pipyns/pipyns.github.io/README.md

# Pipyns -- MTE 481/482 Capstone Endeavor
## Powered by: [TeXt Theme](https://github.com/kitian616/jekyll-TeXt-theme)
