pipyns/pipyns.github.io/_posts/2024-02-18-w17.md

---
title: Capstone Week 17 - Feb 12 to Feb 18 Updates
tags: meeting-notes
show_edit_on_github: false
show_subscribe: false
---

<style>
  img {
  display: block;
  margin-left: auto;
  margin-right: auto;
  }
</style>

## WEEK 17

Week 17 is Week 6 of the W24 term.

### Meeting with Professors
This week the 2nd Meeting with advisors has taken place. The team summarized the progress made over the first half of the term - the meeting was meant as an intermediate check before presenting a working prototype in the final 3rd Meeting.

### Team Progress Update

The weekly meeting was utilized to come up with a roadmap of remaining tasks in all areas.

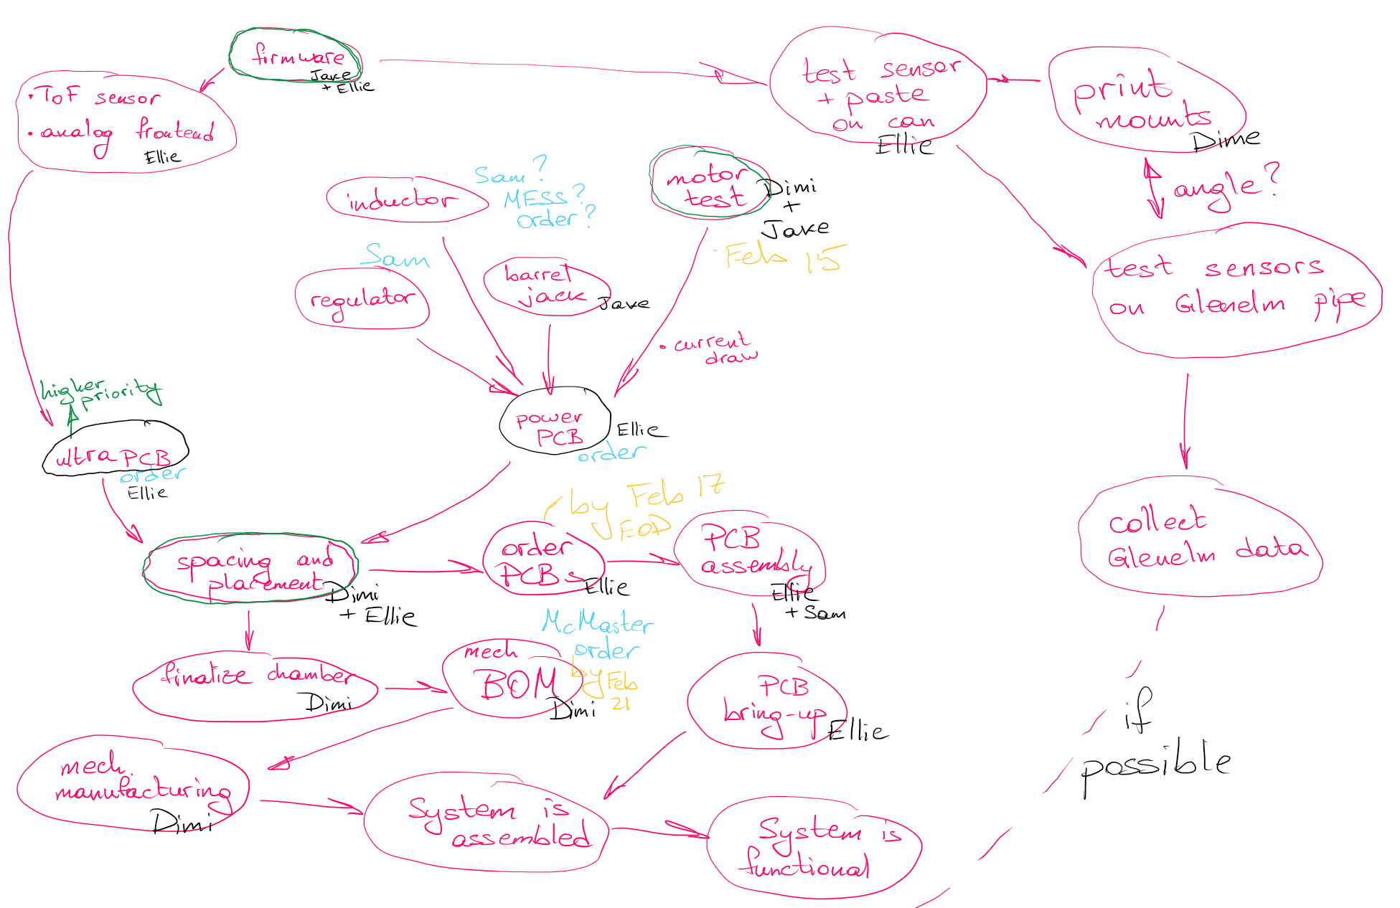
[picture p4: assets/Roadmap1.png]
Image of the first half of the task roadmap


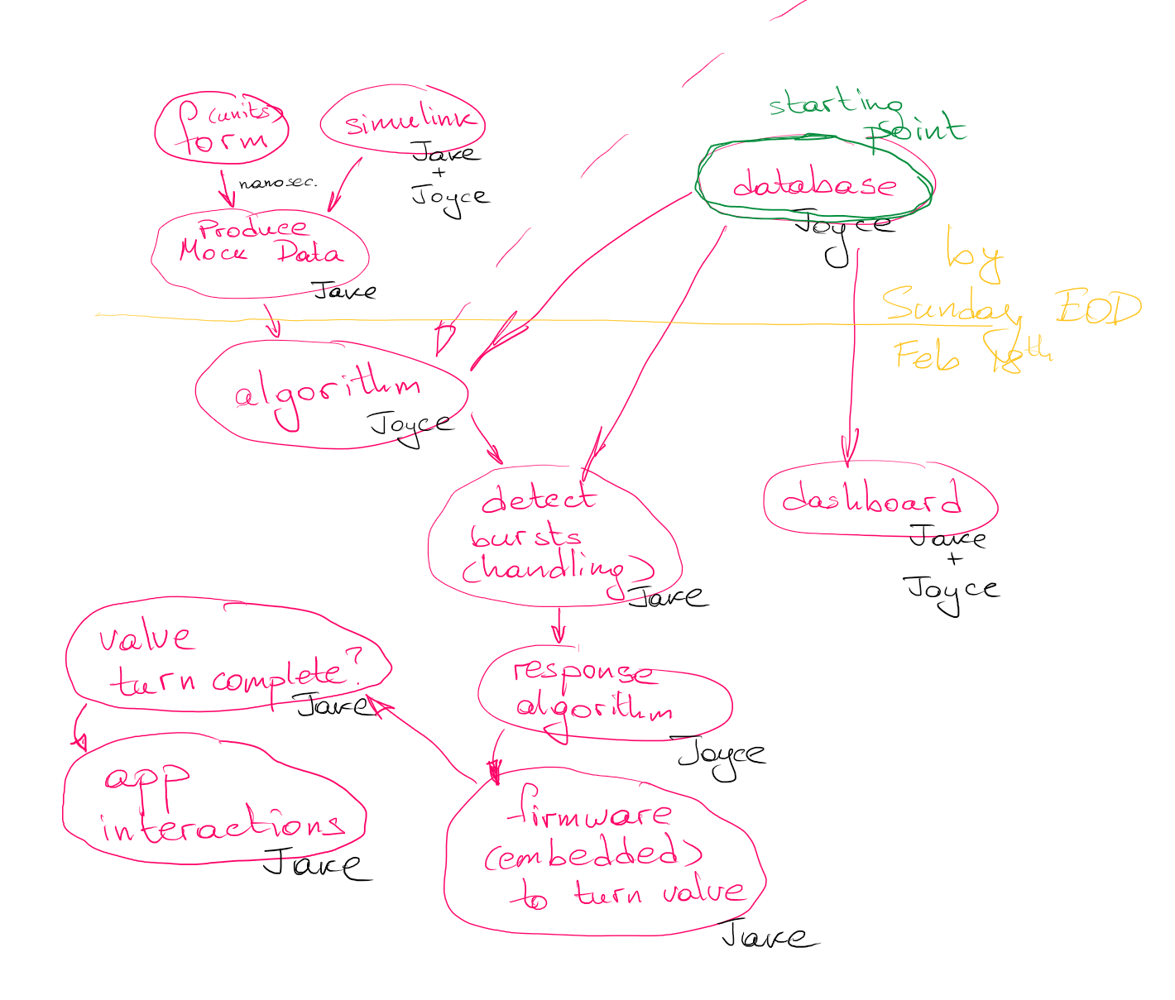
[picture p5: assets/Roadmap2.png]
Image of the second half of the task roadmap


The motor was once again tested to record the current draw, which has shown that the peak does not exceed 2A in typical actuation.

The mechanical design of the waterproof enclosure was reworked into a flatter configuration to redistribute the mass of the system.

The Ultrasonic PCB and the Power PCB were finalized based on the new chamber dimensions and ordered for manufacturing.

### Jake's Weekly Updates
I am literally the messiah

Editor's note: he is
  
<iframe style="border-radius:12px" src="https://open.spotify.com/embed/track/58KPPL1AdLHMvR2O2PZejr?utm_source=generator" width="100%" height="152" frameBorder="0" allowfullscreen="" allow="autoplay; clipboard-write; encrypted-media; fullscreen; picture-in-picture" loading="lazy"></iframe>

<!--more-->
