pipyns/pipyns.github.io/_posts/2024-02-25-w18.md

---
title: Capstone Week 18
tags: meeting-notes
show_edit_on_github: false
show_subscribe: false
---

<style>
  img {
  display: block;
  margin-left: auto;
  margin-right: auto;
  }
</style>

## WEEK 18

Week 18 is Week 7 and the Reading Week of the W24 term.

### Team Progress Update
For this week, the size of the waterproof enclosure for the system was finalized and the parts for it were ordered. On the software side, the simulation for the toilet was successfully completed with the other parts of the washroom still in progress. 
The PCBs on the other awaited their delivery.. 

### Jake's Weekly Updates
"unfortunately the board is not boarding anymore so..."  
<iframe style="border-radius:12px" src="https://open.spotify.com/embed/track/44TuSOP6xIAEeJmZsN3nXO?utm_source=generator" width="100%" height="152" frameBorder="0" allowfullscreen="" allow="autoplay; clipboard-write; encrypted-media; fullscreen; picture-in-picture" loading="lazy"></iframe>

<!--more-->
