pipyns/pipyns.github.io/about.md

---
layout: article
titles:
  # @start locale config
  en      : &EN       About
  en-GB   : *EN
  en-US   : *EN
  en-CA   : *EN
  en-AU   : *EN
  zh-Hans : &ZH_HANS  关于
  zh      : *ZH_HANS
  zh-CN   : *ZH_HANS
  zh-SG   : *ZH_HANS
  zh-Hant : &ZH_HANT  關於
  zh-TW   : *ZH_HANT
  zh-HK   : *ZH_HANT
  ko      : &KO       소개
  ko-KR   : *KO
  fr      : &FR       À propos
  fr-BE   : *FR
  fr-CA   : *FR
  fr-CH   : *FR
  fr-FR   : *FR
  fr-LU   : *FR
  # @end locale config
key: page-about
---

<style>
img {
  display: block;
  margin-left: auto;
  margin-right: auto;
}
</style>

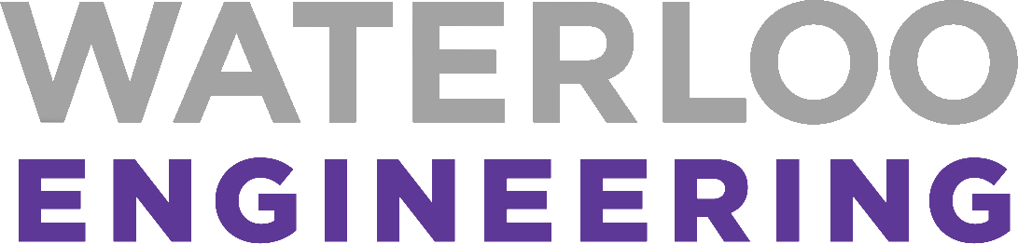
[picture p12: assets/UW_ENG.png]
University of Waterloo


Our team is comprised of Dmitrii Tcyrenov, Ellie Xu, Joyce Ke, and Jakeb Chouinard -- all 4th year Mechatronics Engineering students at the University of Waterloo in Waterloo, Ontario. Thanks to their diverse skillset and previous experiences across different industries, there is no part of this project that seems undoable. Dmitrii is largely mechanically-oriented, having extensive experience in mechanical design and rapid prototyping. Ellie has a variety of experience between electrical and back-end software development, though she will be primarily focused on Electrical system design andily  PCB development. Joyce's experience is largely split between front-end, back-end, and application software development; she will be focusing on the development of the stack necessary to execute this project successfully. Jakeb has experience evenly split between manufacturing and software development. Consequently, his skillset is more varied, and he will be flexibly assisting in each system's development with a focus on software, electronic, and mechanical integration.

If you would like to get in touch with any member of our team, please email pipyns@gmail.com.
