pipyns/pipyns.github.io/ee/old/bandpass filter calculations.docx

Stage 1 calculations

gain= -(R_2)/(R_1), f_(c1) =1/(2πR_1 C_1), f_(c2) =1/(2πR_2 C_2)

Ultrasonic frequency range: 945 KHz – 1005 KHz

Assume input signal is 1 mV, typical of several other ultrasonic flow meters.

total amplification required=5/0.001=5000 max⁡

amplification per stage=√5000=70.7 per stage

Let R1 = 1200 ohms, R2 = 80 000 ohms. Gain = 66.67. Total gain = 4444.67

Let C1 = 150 pF, C2 = 1.8 pF

f_(c1) =1/(2π1200*150*10^(-12))=884 KHz

f_(c2) =1/(2π80000*1.8*10^(-12))=1.105 MHz

Same values for the second stage.

Two stage filter for a roll off gain of -40dB/dec on both corners.
