pipyns/pipyns.github.io/ee/old/BOM.xlsx

Name | Value | Digikey Link | Quantity | Price each | Total
Cap 0805 | 2.7nF | https://www.digikey.ca/en/products/detail/kemet/C0805C272KDRACAUTO/8109833 | 3 | 0.61 | 1.83
Cap 0805 | 10nF | https://www.digikey.ca/en/products/detail/kemet/C0805C103KCRACAUTO/8109825 | 5 | 0.43 | 2.15
Cap 0805 | 22uF | https://www.digikey.ca/en/products/detail/samsung-electro-mechanics/CL21A226KQCLRNC/5961171 | 5 | 0.21 | 1.05
LED 0805 | green | https://www.digikey.ca/en/products/detail/liteon/LTST-C171GKT/386793 | 3 | 0.39 | 1.17
LED 0805 | red | https://www.digikey.ca/en/products/detail/liteon/LTST-C171KRKT/386801 | 3 | 0.43 | 1.29
LED 0805 | yellow | https://www.digikey.ca/en/products/detail/liteon/LTST-C170KSKT/386781 | 3 | 0.49 | 1.47
Buck Conv | AP64500SP-13 | https://www.digikey.ca/en/products/detail/diodes-incorporated/AP64500SP-13/10419714 | 3 | 3.49 | 10.47
Inductor 0805 | 3.5uH | https://www.digikey.ca/en/products/detail/sumida-america-inc/CDRH127NP-3R5NC/700564 | 3 | 2.75 | 8.25
Res 0603 | 25K | https://www.digikey.ca/en/products/detail/panasonic-electronic-components/ERA-3AEB223V/1465886 | 5 | 0.2 | 1
Res 0603 | 5K | https://www.digikey.ca/en/products/detail/yageo/RT0603BRE075KL/7708365 | 5 | 0.24 | 1.2
LDO | AZ1117IH-5.0TRG1 | https://www.digikey.ca/en/products/detail/diodes-incorporated/AZ1117IH-5-0TRG1/5699673 | 5 | 0.58 | 2.9
Total |  |  |  |  | 32.78
