pipyns/pipyns.github.io/ee/schematics/Ultra_PCB_Overall_Size.dxf

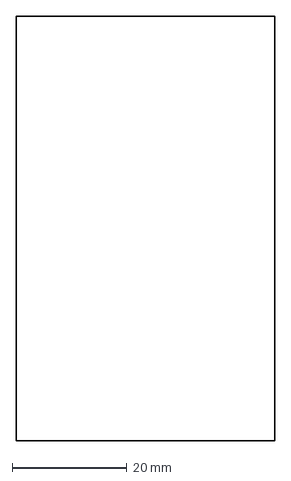
[picture p13: CAD file, 2024-02-21]
ee/schematics/Ultra_PCB_Overall_Size.dxf
45.0 x 74.0 mm
