pipyns/pipyns.github.io/ee/cad/AZ1117IH-5.0TRG1.stp

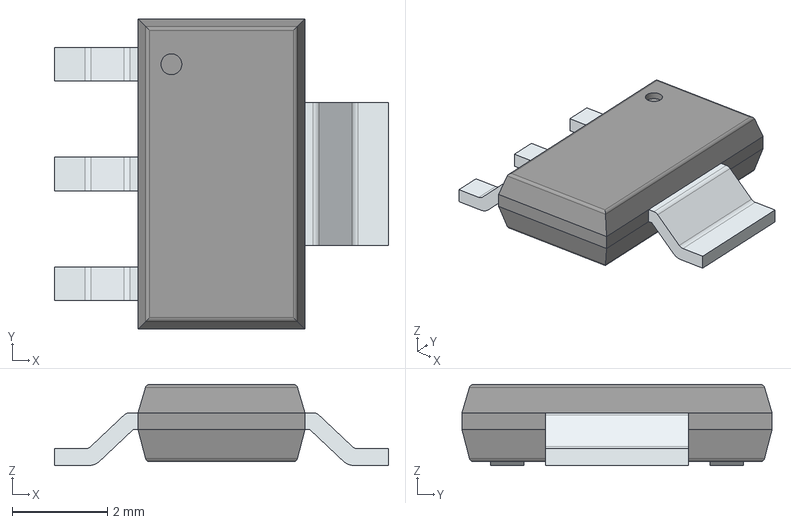
[picture p14: CAD file, 2024-02-21]
ee/cad/AZ1117IH-5.0TRG1.stp
7.00 x 6.50 x 1.70 mm
PinsArrayL
FilletPinR
