pipyns/pipyns.github.io/ee/ppcb paste.dxf

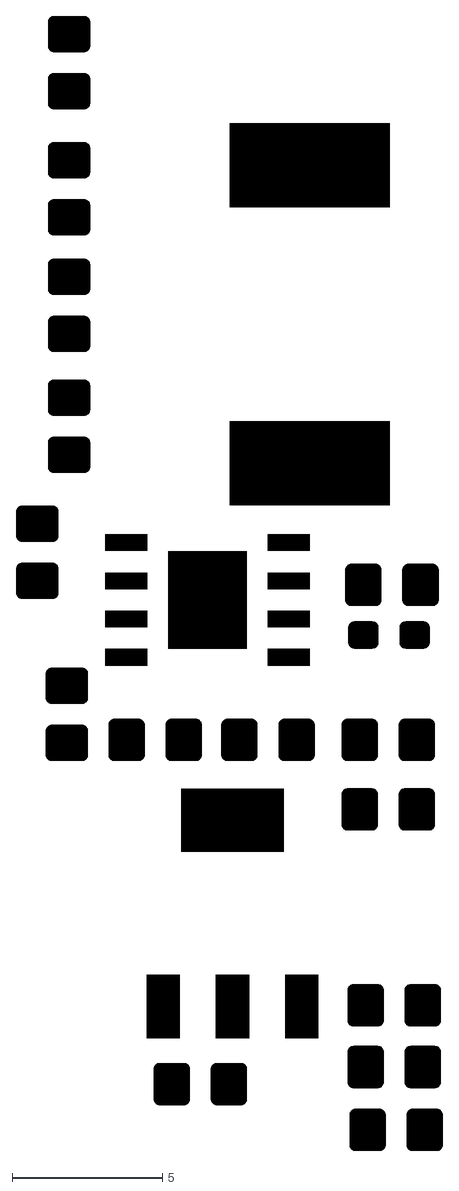
[picture p15: CAD file, 2024-03-05]
ee/ppcb paste.dxf
14.2 x 37.8
