pipyns/pipyns.github.io/ee/schematics/power board/power layout 02-17.step

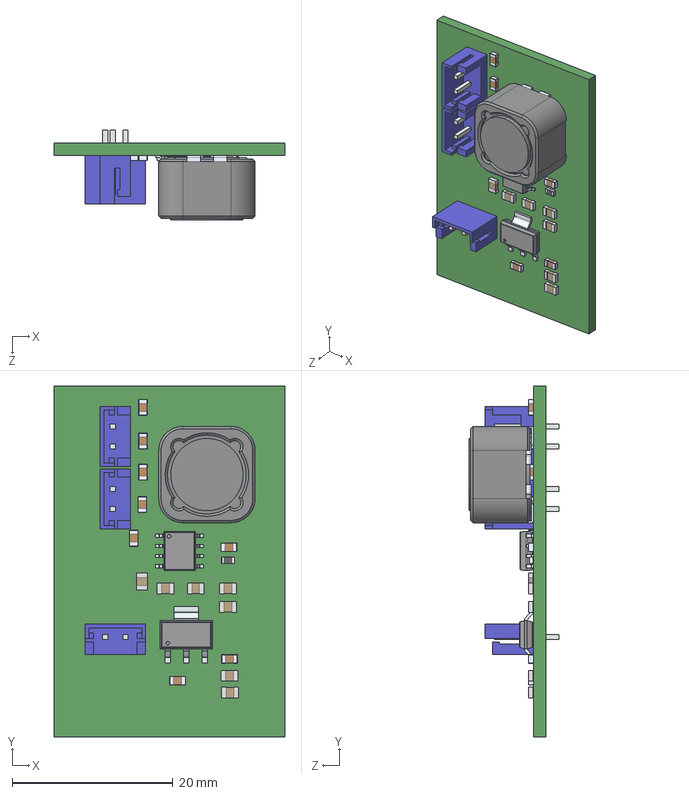
[picture p16: CAD file, 2024-02-21]
ee/schematics/power board/power layout 02-17.step
28.7 x 43.7 x 11.2 mm
Board_power_layout_02-17
0805_cap x 8
0805_resistor x 7
AP64500SP-13
B2B-EH-A x 3
inductor_LDNP-470MC
Resistor_0603
AZ1117IH-5.0TRG1
