pipyns/pipyns.github.io/me/ellie testing/0.75 inch copper pipe/0.75'' copper pipe 60 deg mount.stl

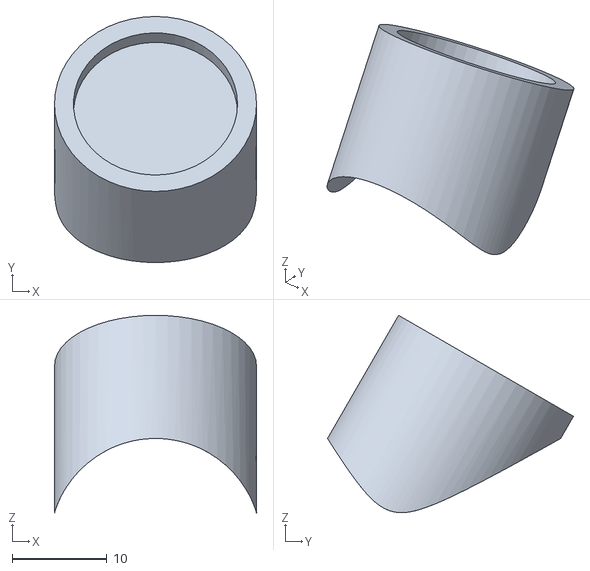
[picture p17: CAD file, 2024-03-25]
me/ellie testing/0.75 inch copper pipe/0.75'' copper pipe 60 deg mount.stl
21.3 x 25.9 x 20.8
