pipyns/pipyns.github.io/me/ellie testing/1 inch copper pipe/3.0 1'' copper pipe 60 deg mount.stl

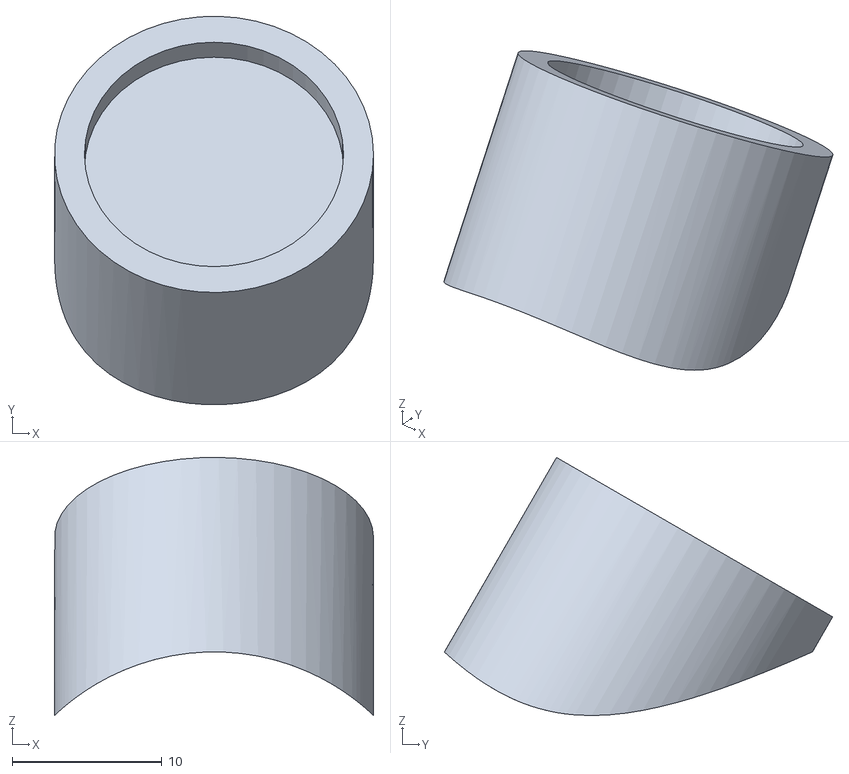
[picture p18: CAD file, 2024-03-25]
me/ellie testing/1 inch copper pipe/3.0 1'' copper pipe 60 deg mount.stl
21.3 x 25.9 x 17.2
