pipyns/pipyns.github.io/me/ellie testing/pla pipes/container od1in.stl

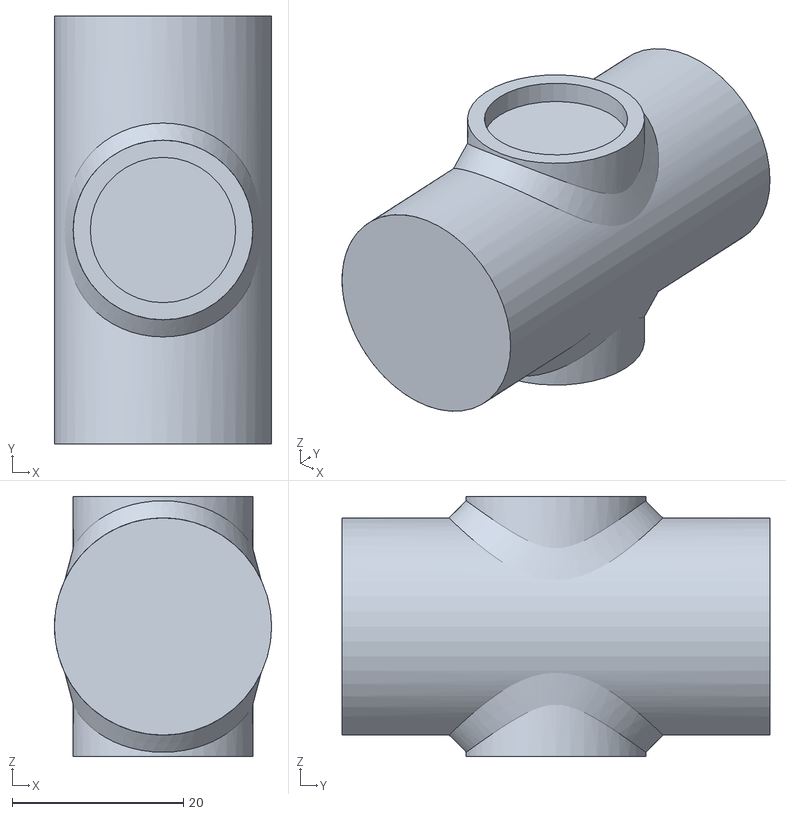
[picture p19: CAD file, 2024-03-22]
me/ellie testing/pla pipes/container od1in.stl
25.4 x 50.0 x 30.4
