pipyns/pipyns.github.io/me/ellie testing/shower jig/eddie church.stl

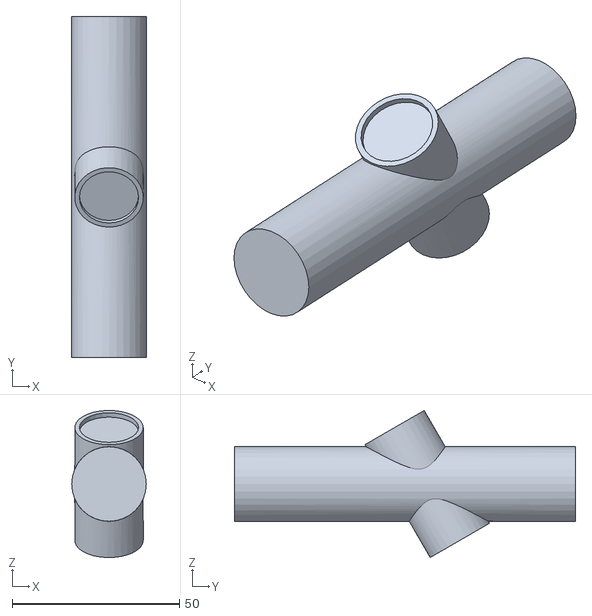
[picture p20: CAD file, 2024-03-22]
me/ellie testing/shower jig/eddie church.stl
22.3 x 102.0 x 44.0
