pipyns/pipyns.github.io/me/ellie testing/shower jig/Shower_Jig_-_V3/Shower_Jig_-_V3.stl

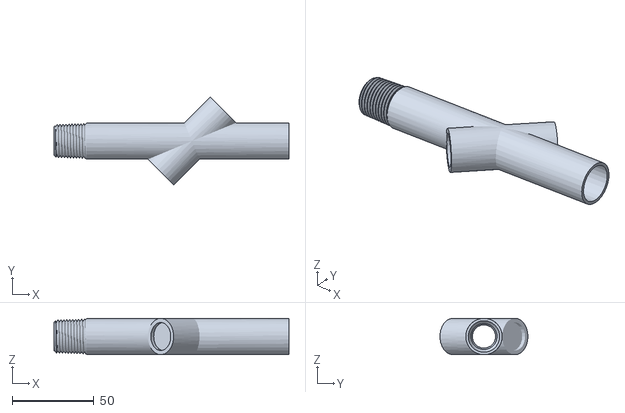
[picture p21: CAD file, 2024-03-22]
me/ellie testing/shower jig/Shower_Jig_-_V3/Shower_Jig_-_V3.stl
144.1 x 53.9 x 22.3
