pipyns/pipyns.github.io/ee/cad/0805 resistor.step

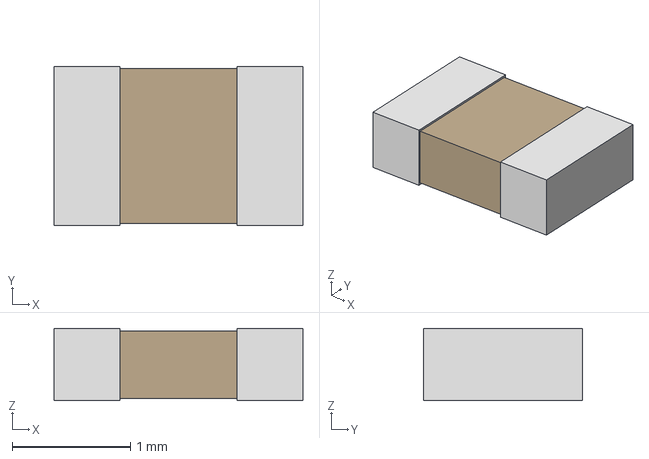
[picture p22: CAD file, 2024-02-21]
ee/cad/0805 resistor.step
2.11 x 1.35 x 0.61 mm
