pipyns/pipyns.github.io/ee/ppcb paste w box.dxf

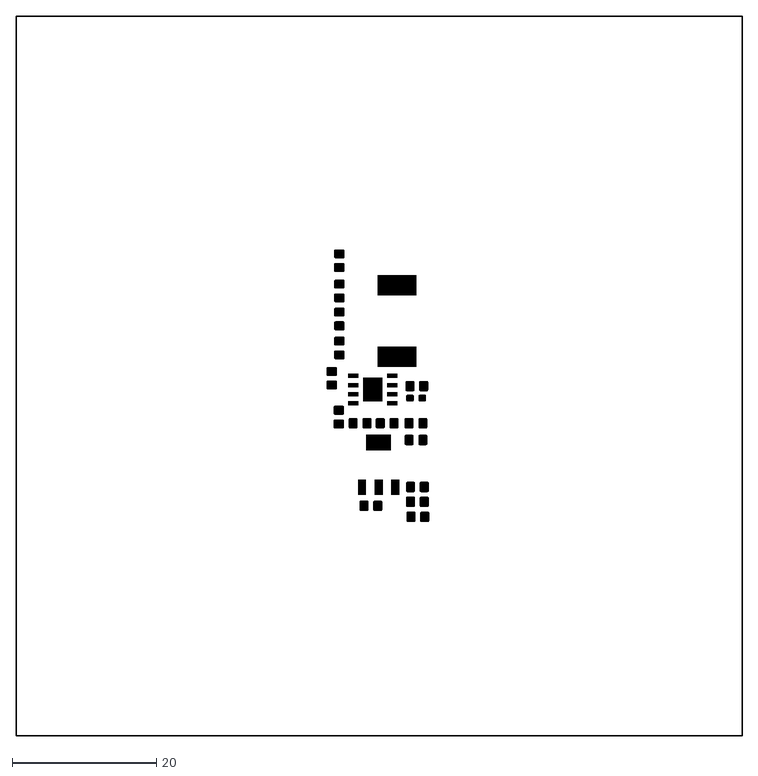
[picture p23: CAD file, 2024-03-05]
ee/ppcb paste w box.dxf
100.6 x 99.7
