pipyns/pipyns.github.io/me/ellie testing/1 inch copper pipe/1'' copper pipe 60 deg mount.stl

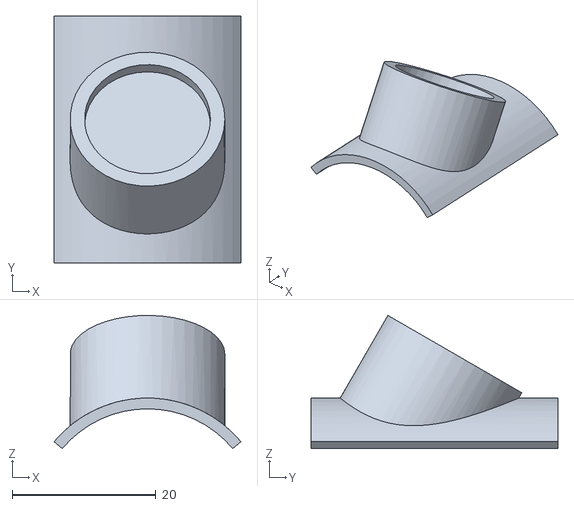
[picture p24: CAD file, 2024-03-22]
me/ellie testing/1 inch copper pipe/1'' copper pipe 60 deg mount.stl
26.0 x 34.3 x 18.5
