pipyns/pipyns.github.io/me/ellie testing/shower jig/shower jig eddie frankenstein.stl

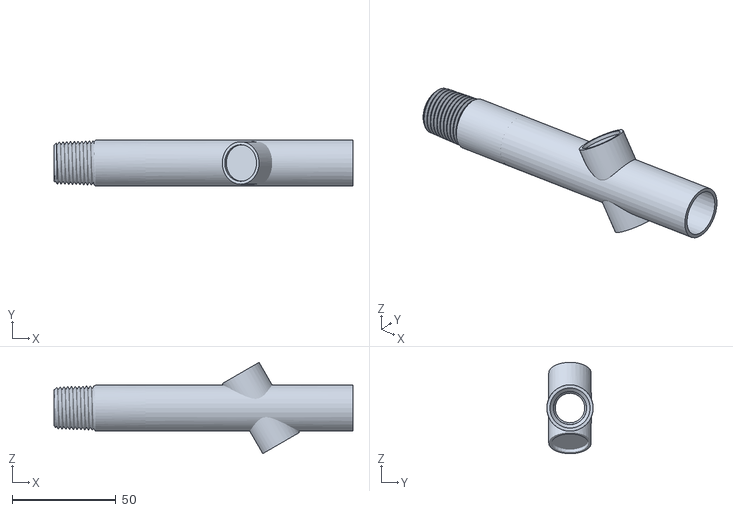
[picture p25: CAD file, 2024-03-22]
me/ellie testing/shower jig/shower jig eddie frankenstein.stl
144.0 x 22.3 x 44.0
