pipyns/pipyns.github.io/ee/cad/inductor LDNP-470MC.STEP

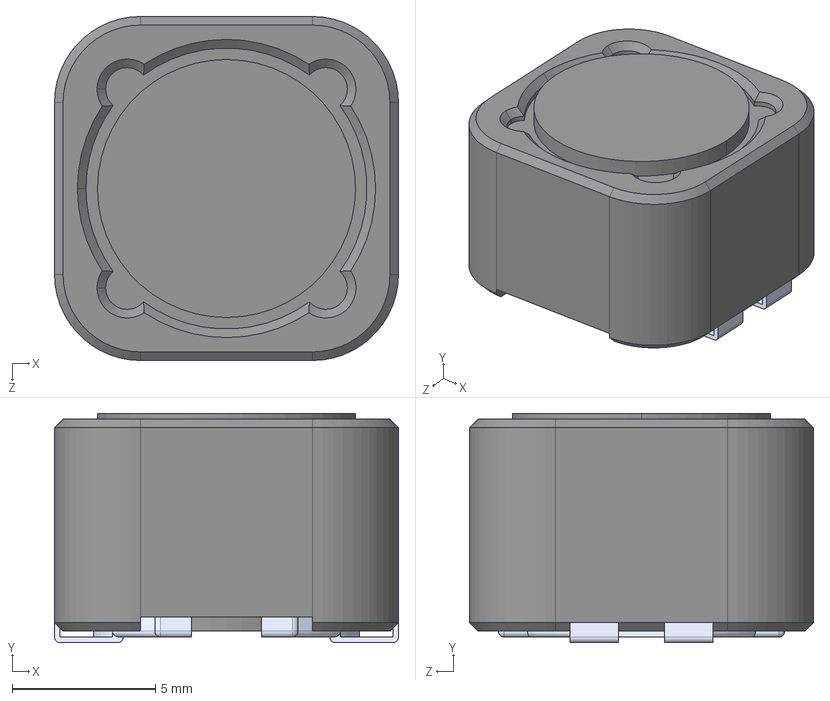
[picture p26: CAD file, 2024-02-21]
ee/cad/inductor LDNP-470MC.STEP
12.0 x 8.00 x 12.0 mm
