pipyns/pipyns.github.io/ee/upcb paste.dxf

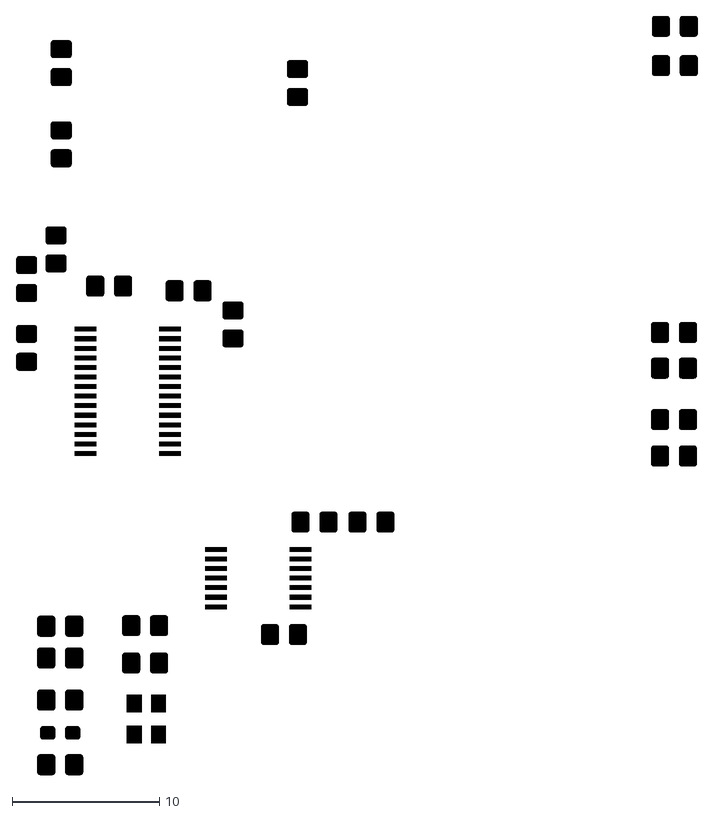
[picture p27: CAD file, 2024-03-05]
ee/upcb paste.dxf
46.3 x 51.6
