pipyns/pipyns.github.io/me/ellie testing/1 inch copper pipe/2.0 1'' copper pipe 60 deg mount.stl

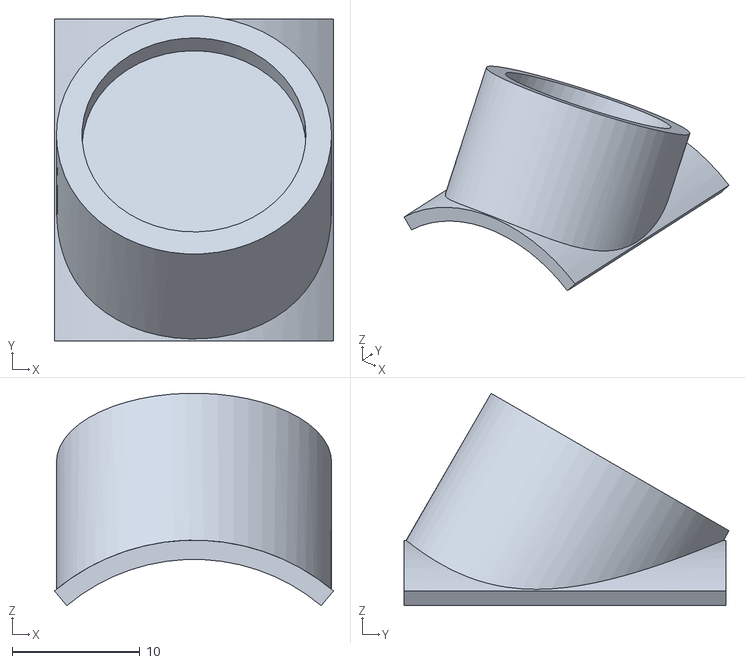
[picture p28: CAD file, 2024-03-22]
me/ellie testing/1 inch copper pipe/2.0 1'' copper pipe 60 deg mount.stl
21.8 x 25.4 x 16.6
