pipyns/pipyns.github.io/ee/cad/Resistor_0603.step

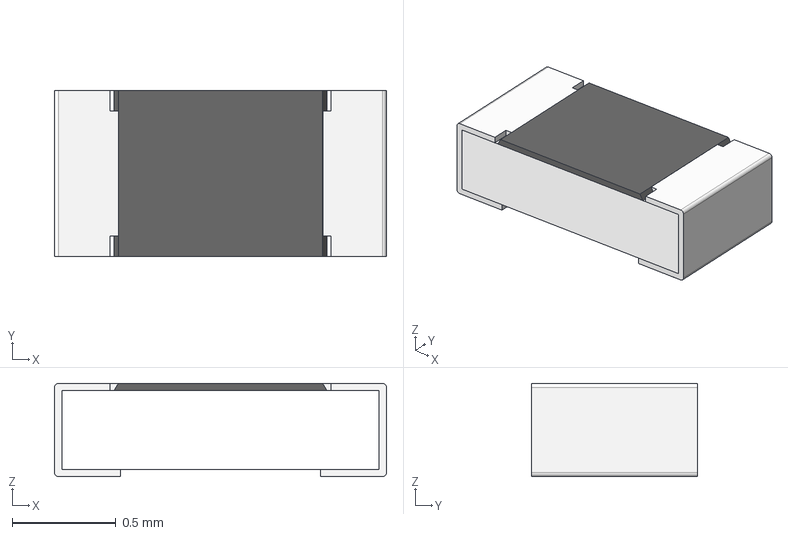
[picture p29: CAD file, 2024-02-21]
ee/cad/Resistor_0603.step
1.60 x 0.8 x 0.45 mm
Pin1Body
Pin2Body
CeramicBody
CoatingBody
