pipyns/pipyns.github.io/ee/upcb paste w box.dxf

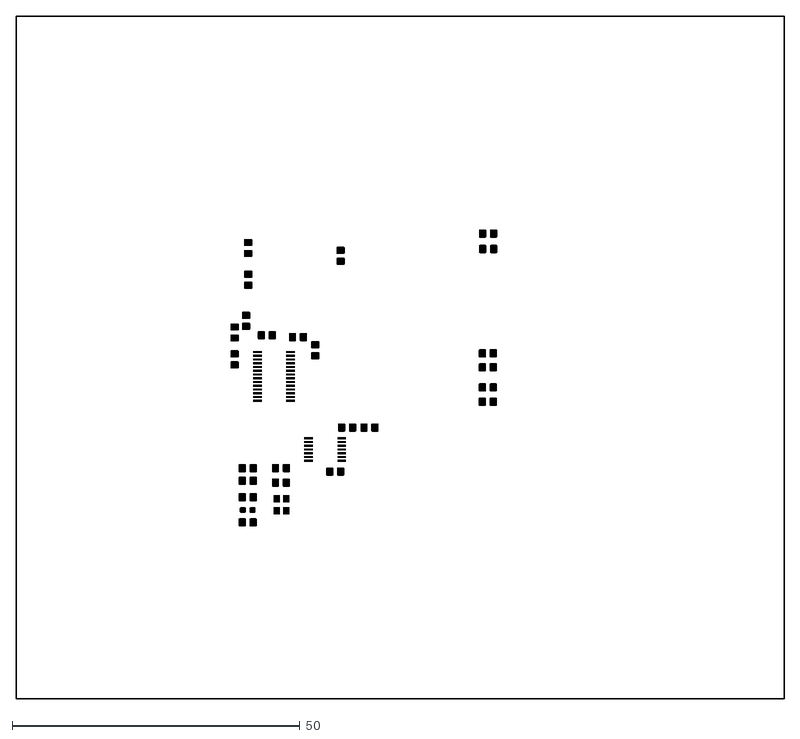
[picture p30: CAD file, 2024-03-05]
ee/upcb paste w box.dxf
133.5 x 118.6
