pipyns/pipyns.github.io/me/ellie testing/1 inch copper pipe/Sensor_Mount_-_Big_Copper_Pipe.stl

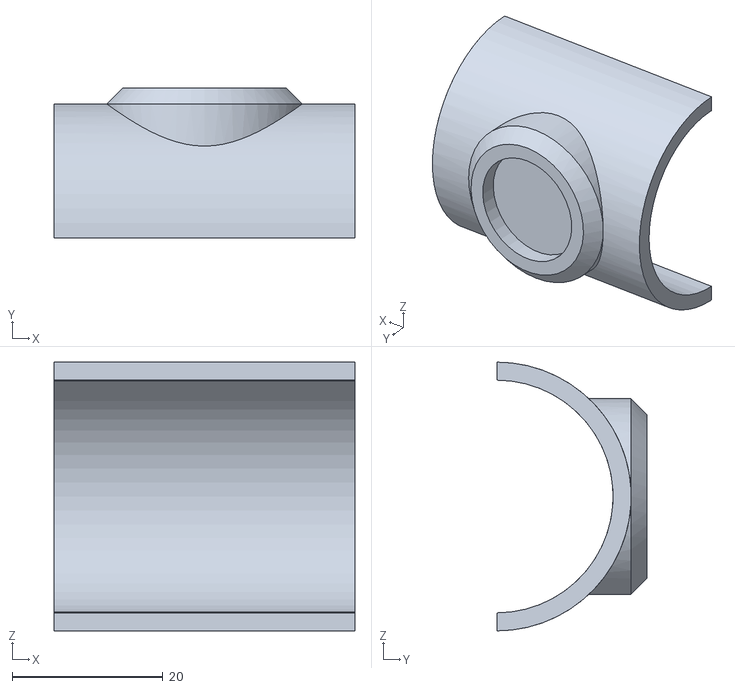
[picture p31: CAD file, 2024-03-22]
me/ellie testing/1 inch copper pipe/Sensor_Mount_-_Big_Copper_Pipe.stl
40.0 x 20.0 x 35.7
