pipyns/pipyns.github.io/ee/cad/0805 cap.step

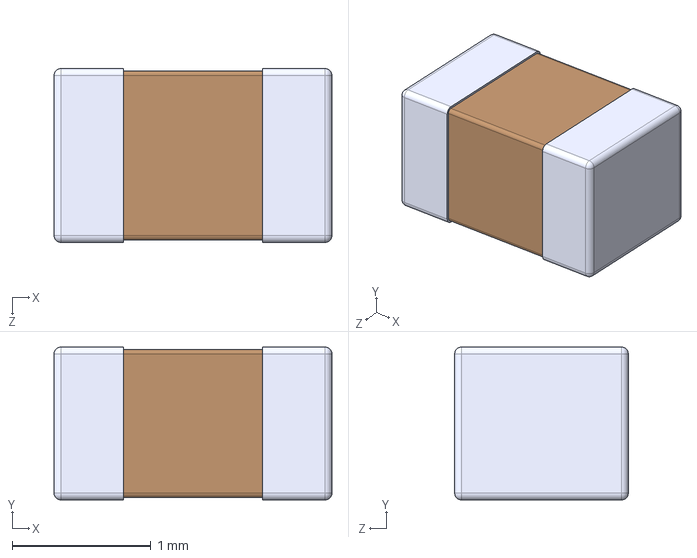
[picture p32: CAD file, 2024-02-21]
ee/cad/0805 cap.step
2.00 x 1.10 x 1.25 mm
