pipyns/pipyns.github.io/ee/cad/ASEMB.STEP

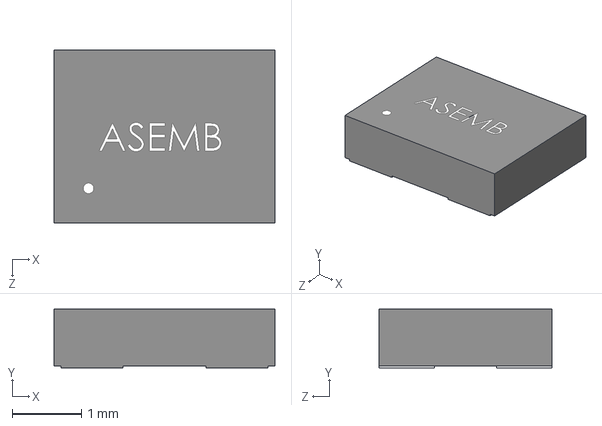
[picture p33: CAD file, 2024-02-21]
ee/cad/ASEMB.STEP
3.20 x 0.85 x 2.50 mm
