pipyns/pipyns.github.io/ee/cad/B2B-EH-A.STEP

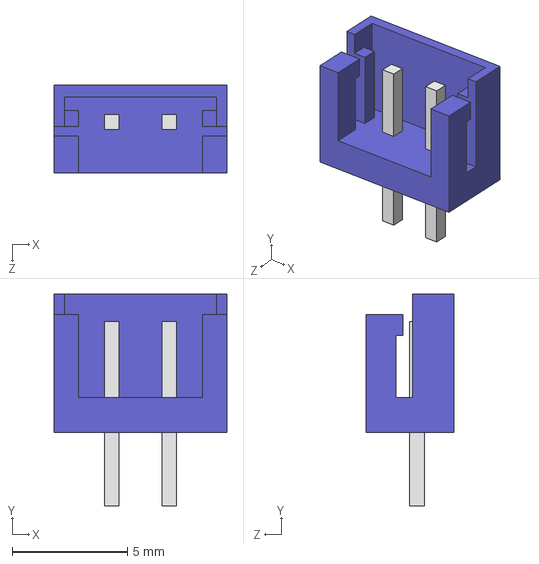
[picture p34: CAD file, 2024-02-21]
ee/cad/B2B-EH-A.STEP
7.50 x 9.20 x 3.80 mm
