pipyns/pipyns.github.io/ee/cad/tdc1000.stp

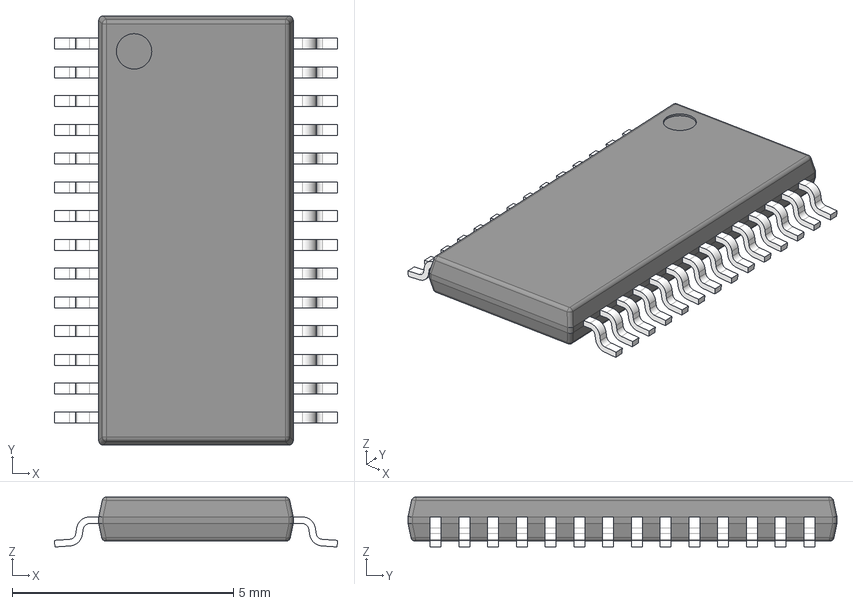
[picture p35: CAD file, 2024-02-21]
ee/cad/tdc1000.stp
6.40 x 9.70 x 1.13 mm
BODY-TSSOP
LEAD-TSSOP x 28
PIN1
