pipyns/pipyns.github.io/ee/cad/tdc7200.stp

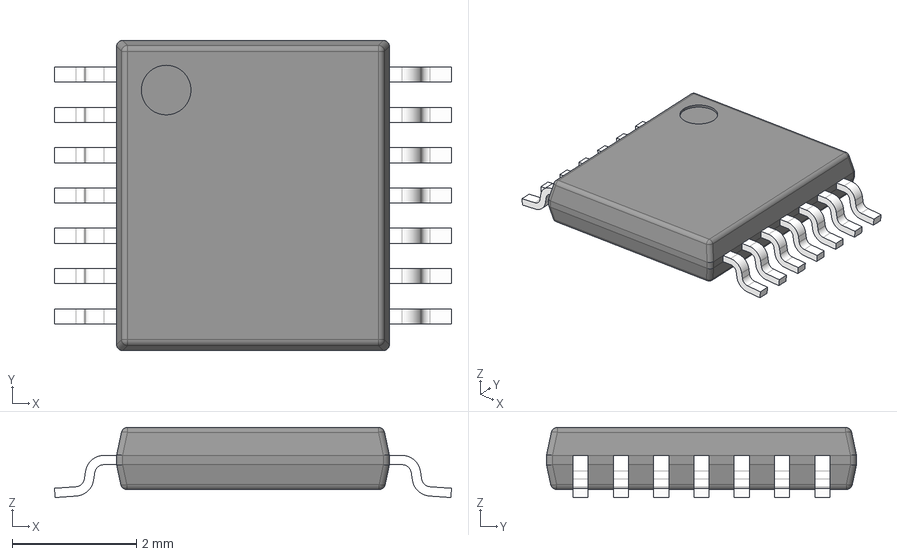
[picture p36: CAD file, 2024-02-21]
ee/cad/tdc7200.stp
6.40 x 5.00 x 1.13 mm
BODY-TSSOP
LEAD-TSSOP x 14
PIN1
