pipyns/pipyns.github.io/(list of files, cad)

Other CAD files:
ee/cad/AP64500SP-13.stp
me/ellie testing/0.75 inch copper pipe/1'' copper pipe 60 deg mount.ipt
me/ellie testing/0.75 inch copper pipe/OldVersions/0.75'' copper pipe 60 deg mount.0006.ipt
me/ellie testing/1 inch copper pipe/1'' copper pipe 60 deg mount.ipt
me/ellie testing/1 inch copper pipe/OldVersions/1'' copper pipe 60 deg mount.0005.ipt
me/ellie testing/1 inch copper pipe/Sensor_Mount_-_Big_Copper_Pipe.ipt
me/ellie testing/pla pipes/container od1in.ipt
me/ellie testing/pla pipes/container od5cm.ipt
me/ellie testing/shower jig/Shower_Jig_-_V3/OldVersions/Shower_Jig_-_V3.0002.ipt
me/ellie testing/shower jig/Shower_Jig_-_V3/Shower_Jig_-_V3.ipt
me/ellie testing/shower jig/eddie church.ipt
me/ellie testing/shower jig/shower jig eddie frankenstein.iam
