pipyns/pipyns.github.io/ee/master pcb layer 1 2-17-24.pdf

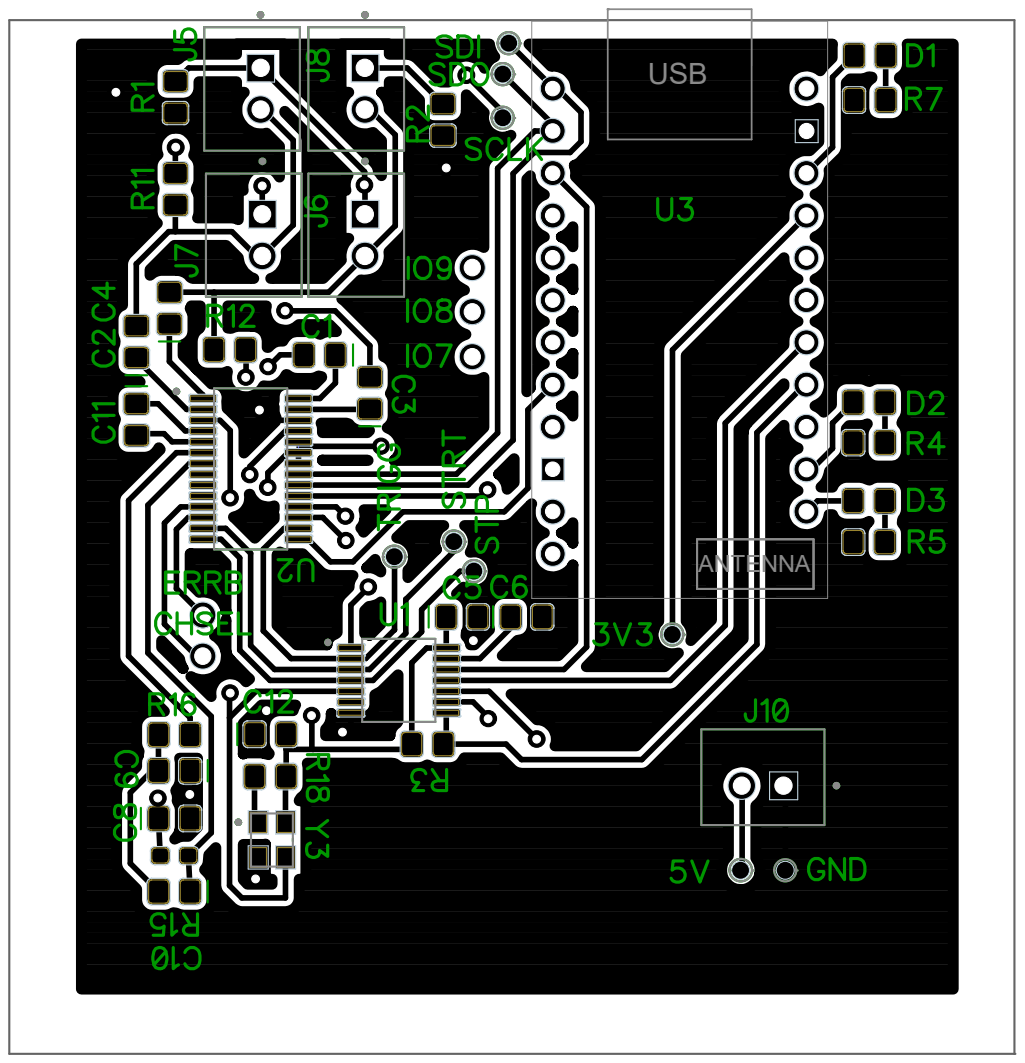
[picture p37: page 1]
ANTENNA; USB
