pipyns/pipyns.github.io/ee/pboard schematic 3-08-2024.pdf

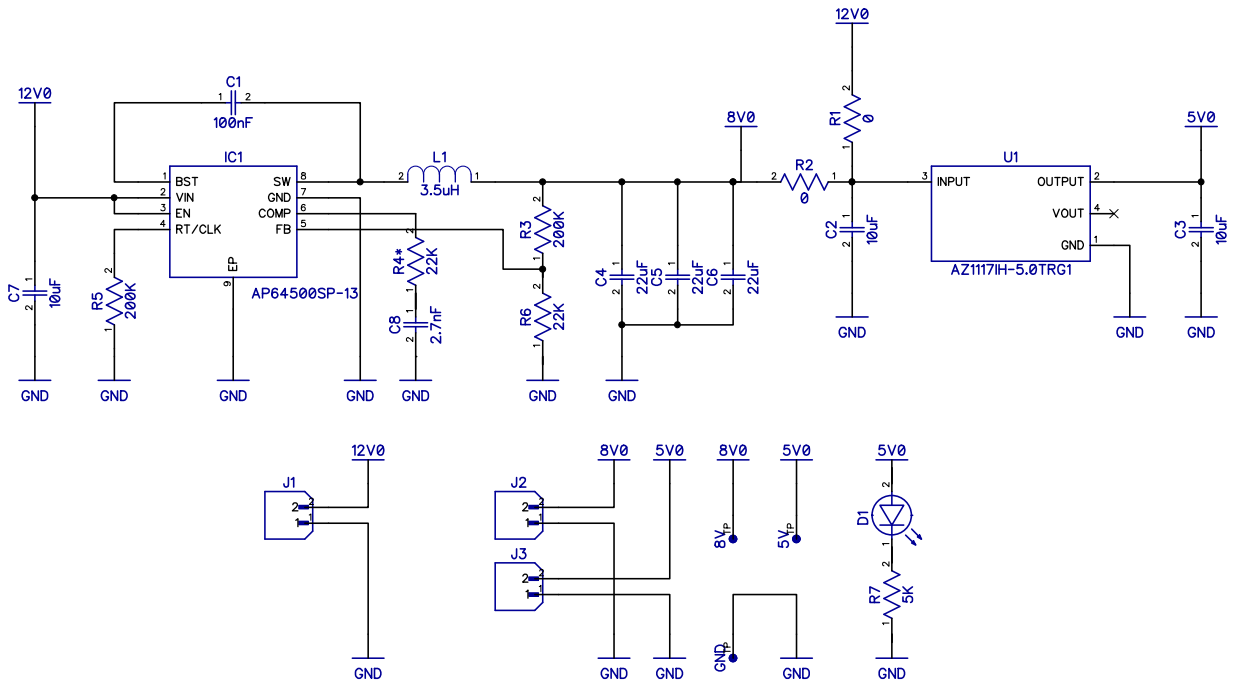
[picture p38: page 1]
