pipyns/pipyns.github.io/ee/pboard schematic 2-26-2024.pdf

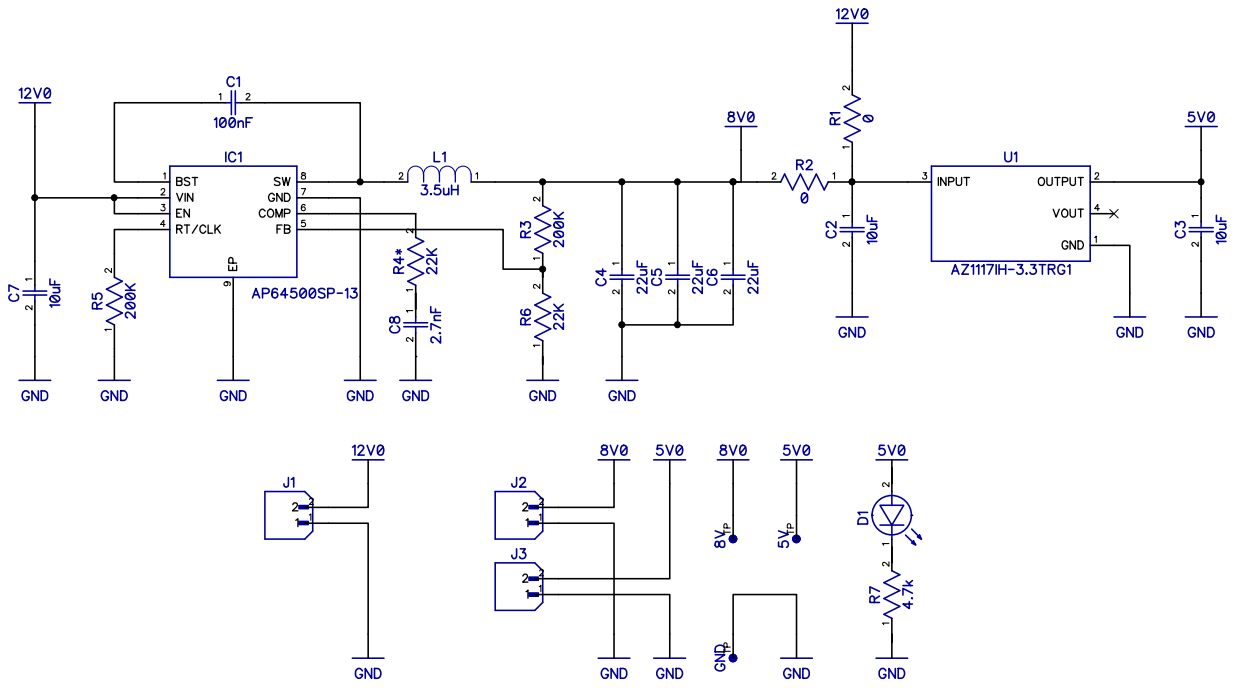
[picture p39: page 1]
