pipyns/pipyns.github.io/ee/uboard schematic 2-26-2024.pdf

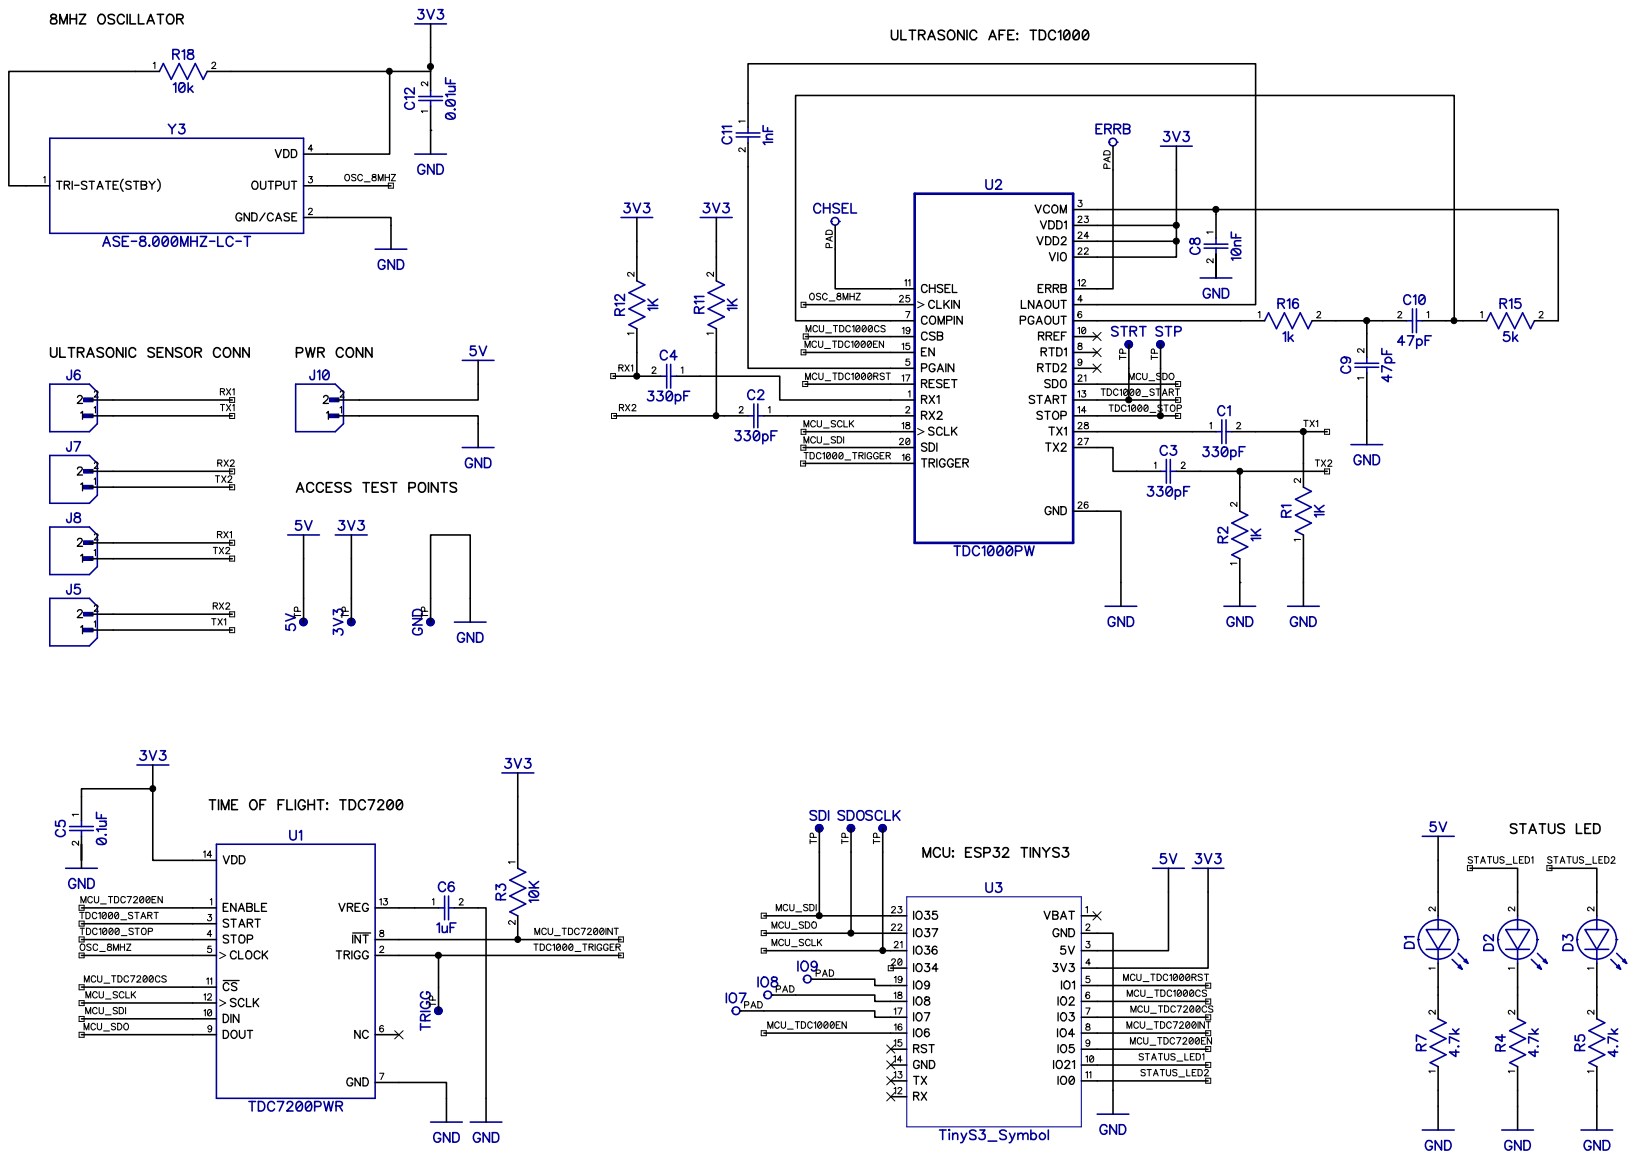
[picture p40: page 1]
