pipyns/pipyns.github.io/ee/power schematic 2-17-24.pdf

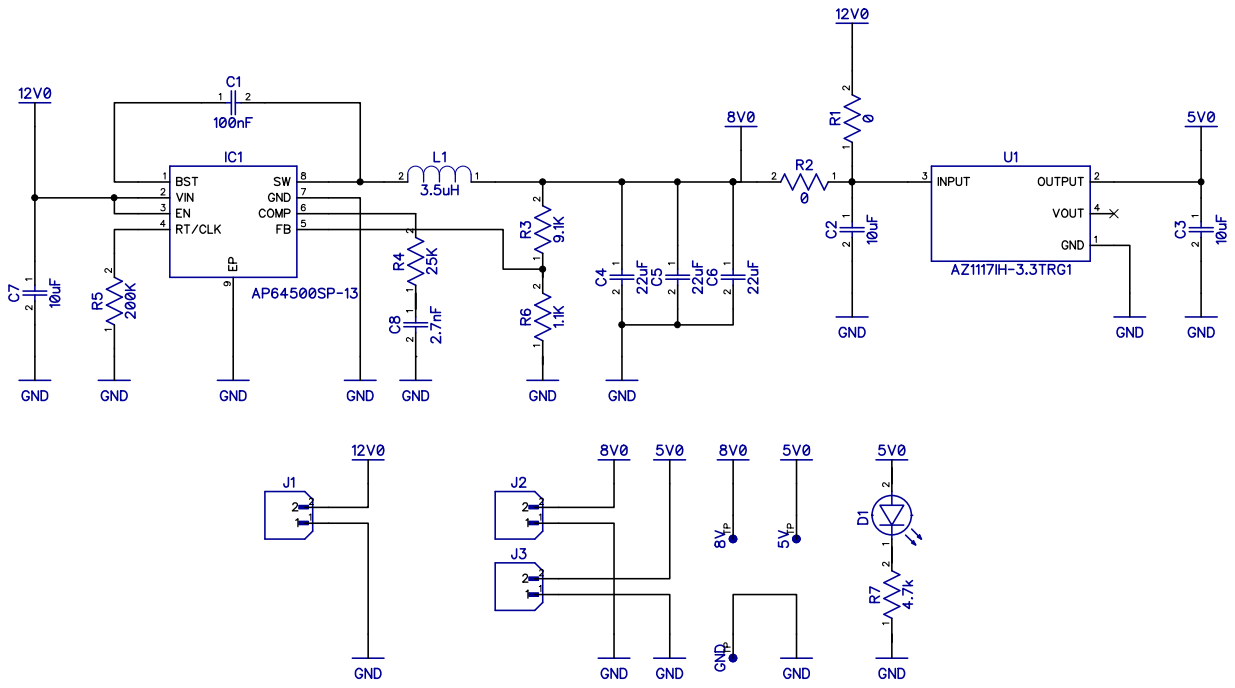
[picture p41: page 1]
