pipyns/pipyns.github.io/ee/schematics/ultrasonic AFE only tdc1000 1-31-24.pdf

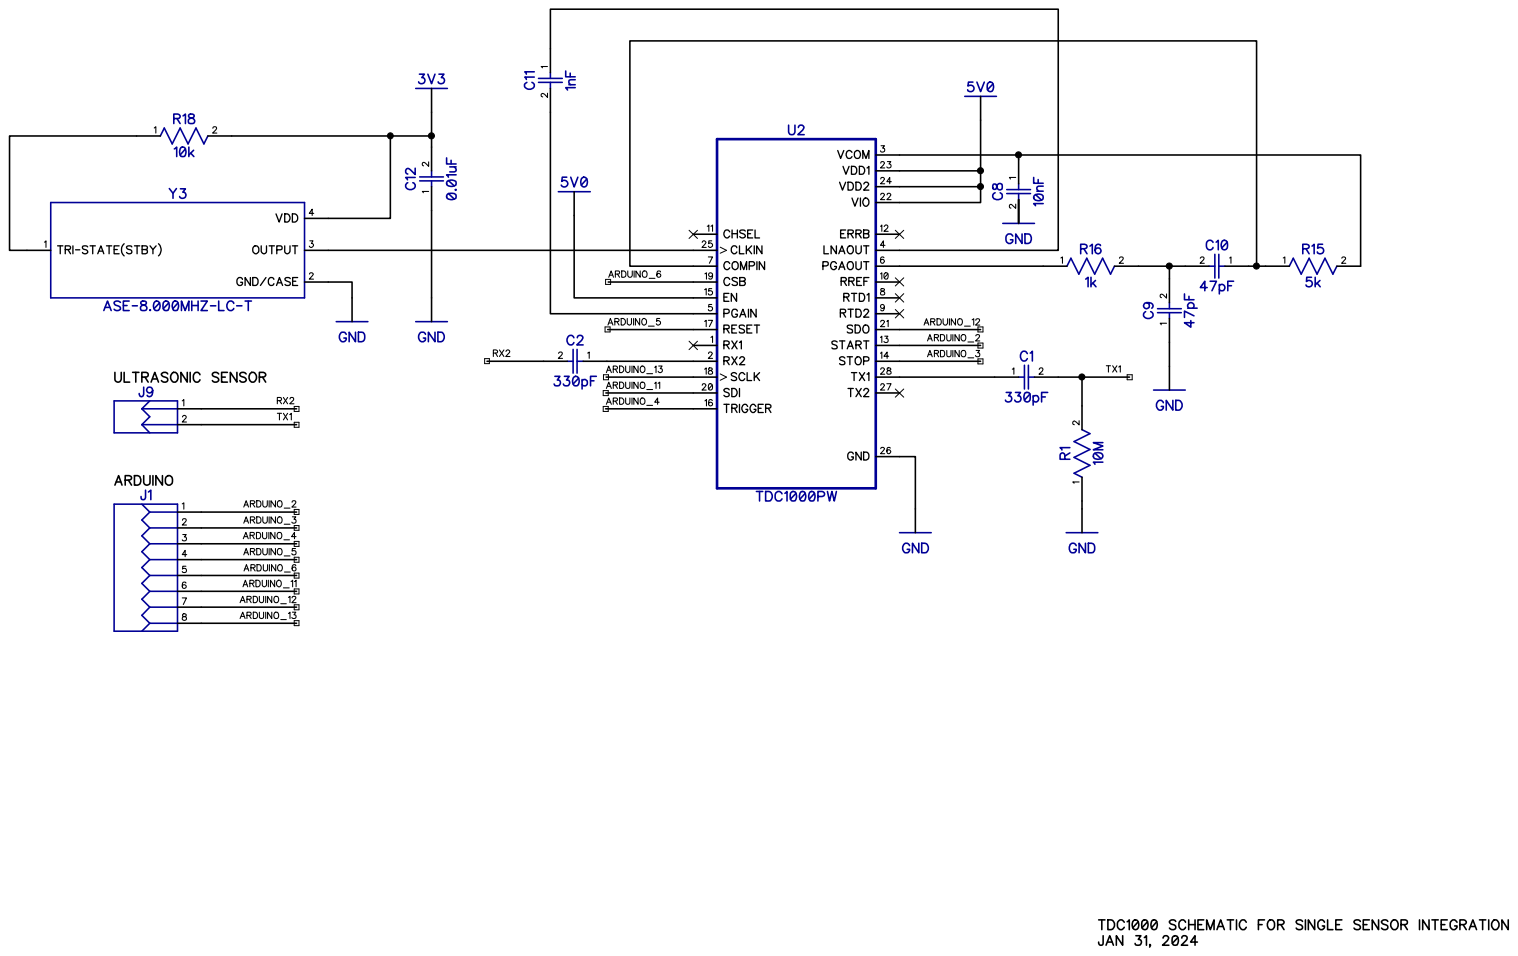
[picture p42: page 1]
