pipyns/pipyns.github.io/ee/master pcb layer 2 2-17-24.pdf

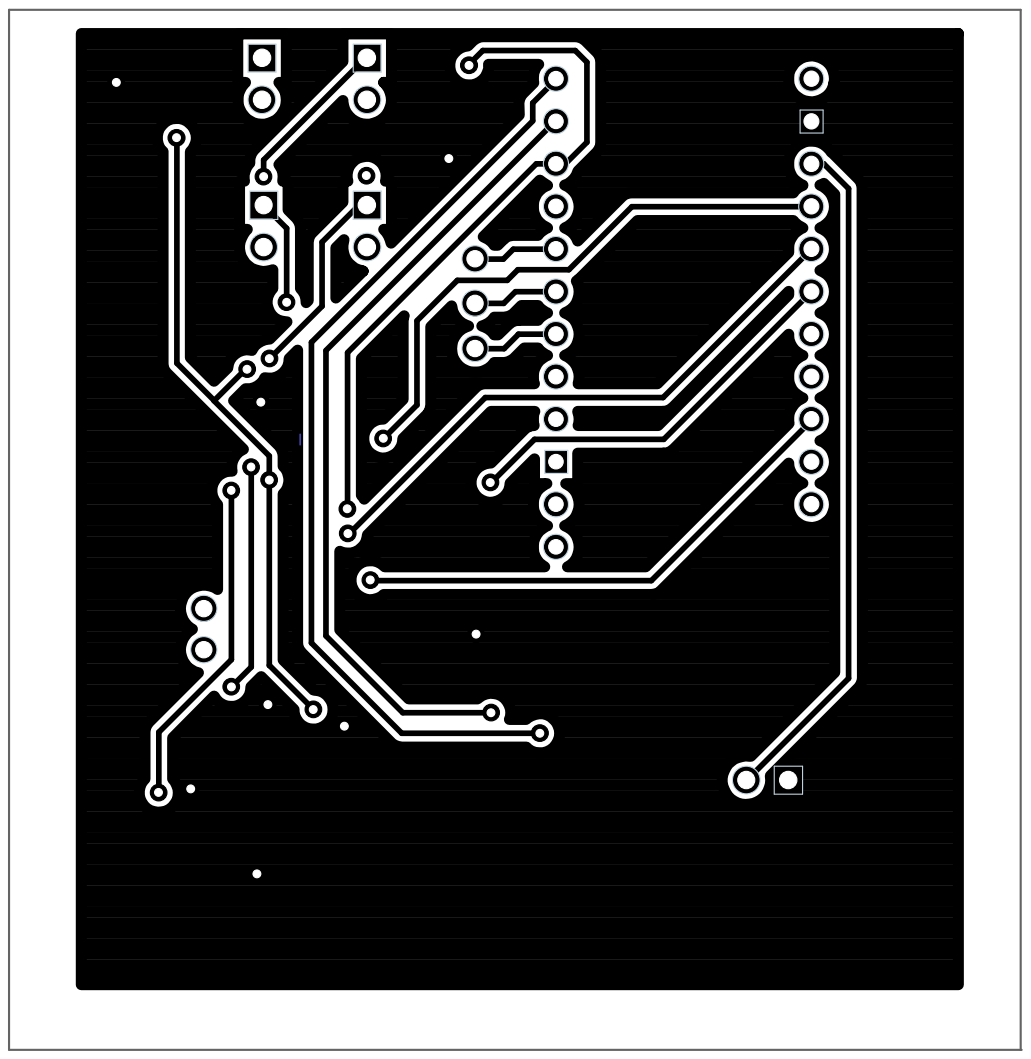
[picture p43: page 1]
