pipyns/pipyns.github.io/ee/power pcb layer 1 2-17-24.pdf

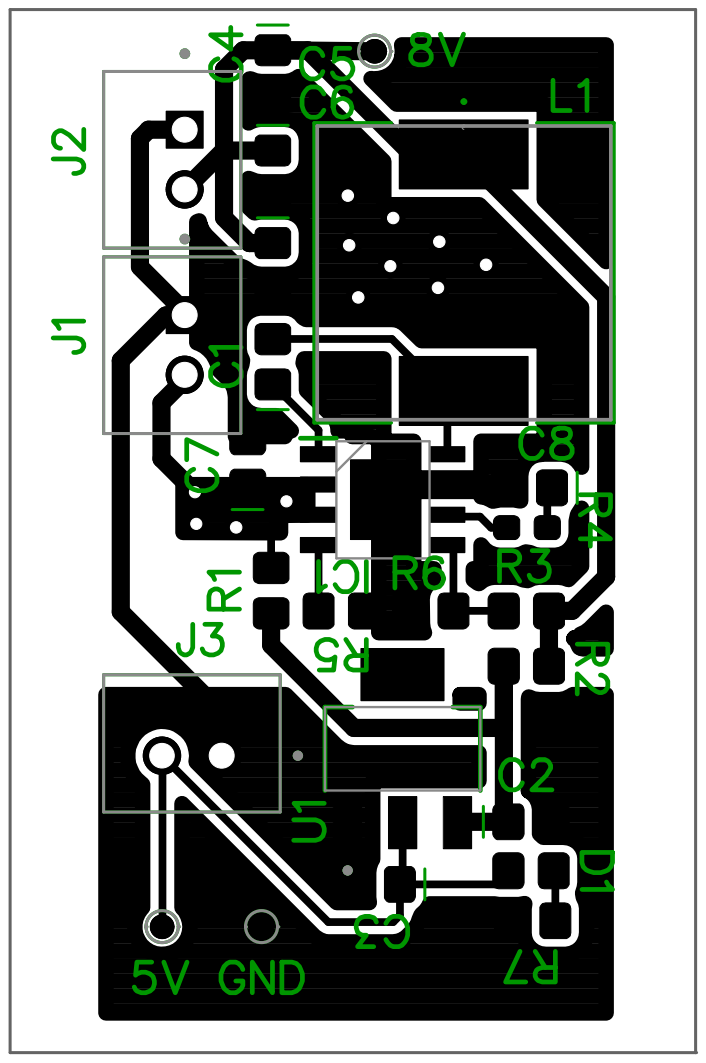
[picture p44: page 1]
