pipyns/pipyns.github.io/ee/old/master schematic 2-13-24.pdf

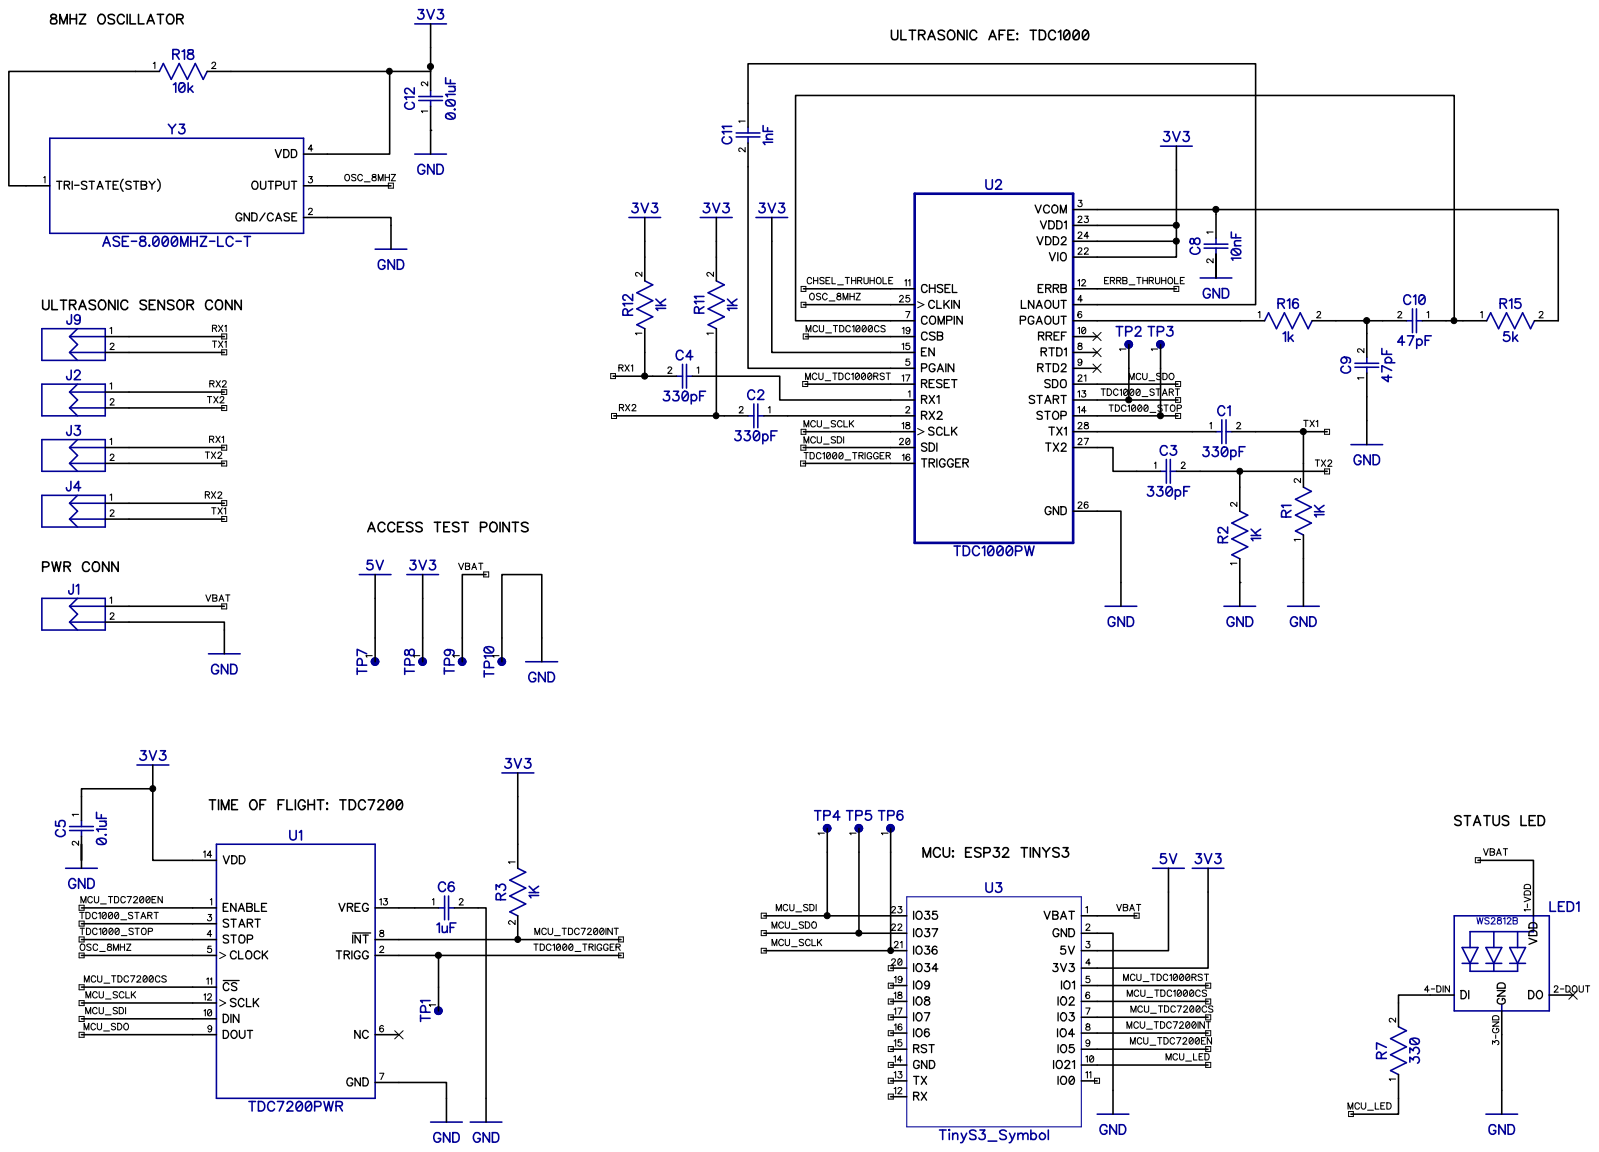
[picture p45: page 1]
