pipyns/pipyns.github.io/(list of files, drawings)

Other design files:
ee/old/draft schematic.dch
ee/old/ultrasonic AFE.dch
ee/schematics/power board/power layout.dip
ee/schematics/power board/power schematic.dch
ee/schematics/ultrasonic board/master layout.dip
ee/schematics/ultrasonic board/master schematic.dch
