pipyns/pipyns.github.io/(commit log)

2023-11-18 adding ee files for backup
    [schematic.dch]
2023-12-01 modifying landing
2023-12-01 shifting landing
2023-12-03 landing page changes
2023-12-17 some schematic changes
    [schematic.dch]
2024-01-31 updated schematic
    [ultrasonic AFE.dch]
2024-02-06 updated pull down resistor value
    [ultrasonic AFE.dch]
2024-02-14 made a bunch of updates to ee
    [draft schematic.dch, master schematic.dch, power schematic.dch, schematic.dch]
2024-02-17 pcb updates for pwr + ultra boards
    [0805 cap.step, 0805 resistor.step, AP64500SP-13.stp, ASEMB.STEP, AZ1117IH-5.0TRG1.stp, B2B-EH-A.STEP, Resistor_0603.step, Ultra_PCB_Overall_Size.dxf]
2024-02-17 made some pdfs for ease of access
    [master layout.dip, master schematic.dch, power layout 02-17.step, power layout.dip, power schematic.dch]
2024-02-17 added BOM for sam
    [BOM.xlsx]
2024-03-08 fixed typo and updated label on pboard
    [power schematic.dch]
2024-03-12 extra gen
    [Test3_LinearRateApproxWithNoise.csv]
2024-03-18 me cad files
    [Sensor_Mount_-_Big_Copper_Pipe.ipt, Sensor_Mount_-_Big_Copper_Pipe.stl, container od1in.0009.ipt, container od1in.ipt, container od1in.stl, container od5cm.ipt]
2024-03-20 lots of me updates
    [Shower_Jig_-_V3.0002.ipt, Shower_Jig_-_V3.ipt, Shower_Jig_-_V3.stl, eddie church.0012.ipt, eddie church.ipt, eddie church.stl, shower jig eddie frankenstein.iam, shower jig eddie frankenstein.stl]
2024-03-22 mech file updates
    [1'' copper pipe 60 deg mount.ipt, 1'' copper pipe 60 deg mount.stl, 2.0 1'' copper pipe 60 deg mount.stl, Sensor_Mount_-_Big_Copper_Pipe.ipt, Sensor_Mount_-_Big_Copper_Pipe.stl, Shower_Jig_-_V3.0002.ipt, Shower_Jig_-_V3.ipt, Shower_Jig_-_V3.stl]
2024-03-22 first irl data
    [intrusive data march 21 shower jig v4.xlsx]
2024-03-25 me files
    [0.75'' copper pipe 60 deg mount.0006.ipt, 0.75'' copper pipe 60 deg mount.stl, 1'' copper pipe 60 deg mount.0005.ipt, 1'' copper pipe 60 deg mount.ipt, 3.0 1'' copper pipe 60 deg mount.stl]
